rhys-mnLuff/FMS-Center/website/intro site/images/bench-calibration-poster.jpg

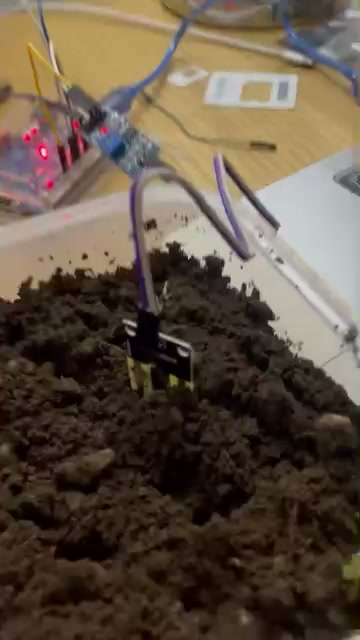
website/intro site/images/bench-calibration-poster.jpg
