rhys-mnLuff/FMS-Center/website/intro site/images/context-paddy-farmers.jpg

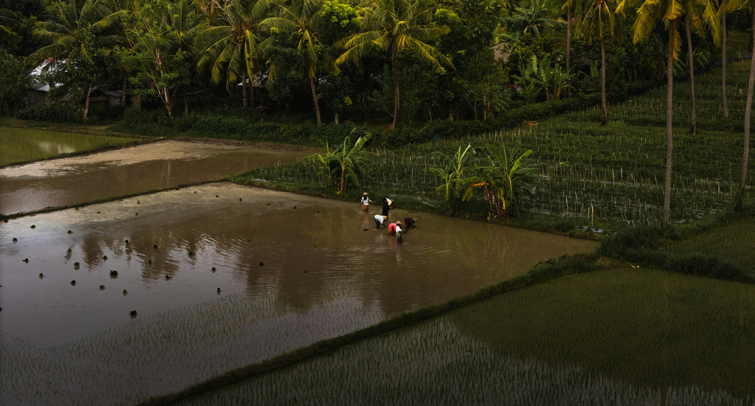
website/intro site/images/context-paddy-farmers.jpg
