rhys-mnLuff/FMS-Center/ROADMAP.md

# Roadmap

Pulled directly from the project's live goal tracker. Status and target dates are real and current as of September 2026 — this file should be updated as goals move, not left to drift out of sync.

## North Star (target: September 2027)

**FMS is a deployed, recognized flood-warning system with documented real-world impact.**

Success criteria: at least one institutional partner has FMS installed; logged alert data from real conditions; at least one national or international recognition; a public writeup a stranger can read and understand.

Why it matters: this is the version of FMS that reads as extraordinary rather than as a school project — real units in real locations, real people relying on the alerts, outside recognition confirming it. Everything else below is a step toward this.

## Quarterly goals

| Goal | Target date | Status | Success criteria |
|---|---|---|---|
| End-to-end prototype on video: water trigger → SMS with location → cloud dashboard | 2026-09-21 | In progress | One unbroken take: dunk test fires an SMS with correct coordinates and a matching dashboard entry, using the soldered HC-12 modules and the SIM module |
| Signed pilot or partnership with PDRF or an equivalent institution | 2026-11-30 | In progress | A written agreement, letter of support, or documented pilot layout naming FMS and a partner organization |
| First field deployment with logged real-condition data | 2026-12-15 | Not started | At least one unit installed outside a workbench, running 2+ weeks, with a data record and install photos |
| Submit to Congressional App Challenge and National STEM Challenge | 2026-11-01 | Not started | Both entries submitted before deadline with a finished pitch video, working demo, and writeup |
| FMS survives a posting change — a local maintainer can service a unit without Rhys | 2027-03-31 | Not started | At least one person who isn't Rhys has assembled or serviced a unit using only the written documentation, and can be named as a local maintainer |

## Monthly goals

| Goal | Target date | Status |
|---|---|---|
| Public presence live: project site, GitHub repo, technical writeup | 2026-09-30 | Not started (this repo is the first piece of it) |
| Secure a technical mentor for FMS | 2026-09-30 | Not started |
| Capture the full six-shot competition footage set | 2026-09-25 | Not started |

## Why "FMS survives a posting change" is on this list

Foreign Service postings end. If FMS only works while Rhys is in Manila holding it together, it's a project. If a Filipino partner can build, install, and service units from the documentation alone, it's infrastructure. That's also the honest version of the work — a flood system for Metro Manila should belong to the people who live with the flooding, not depend indefinitely on the person who happened to build the first one.

## What's deliberately not on this list yet

Multi-hop mesh routing, a finalized solar/battery spec, and a signed field deployment are all real next steps, but none of them have a committed target date in the tracker yet. They belong in this roadmap once they do — adding speculative dates here would undercut the point of keeping this file accurate.
