rhys-mnLuff/FMS-Center/website/intro site/images/context-flood-aerial.jpg

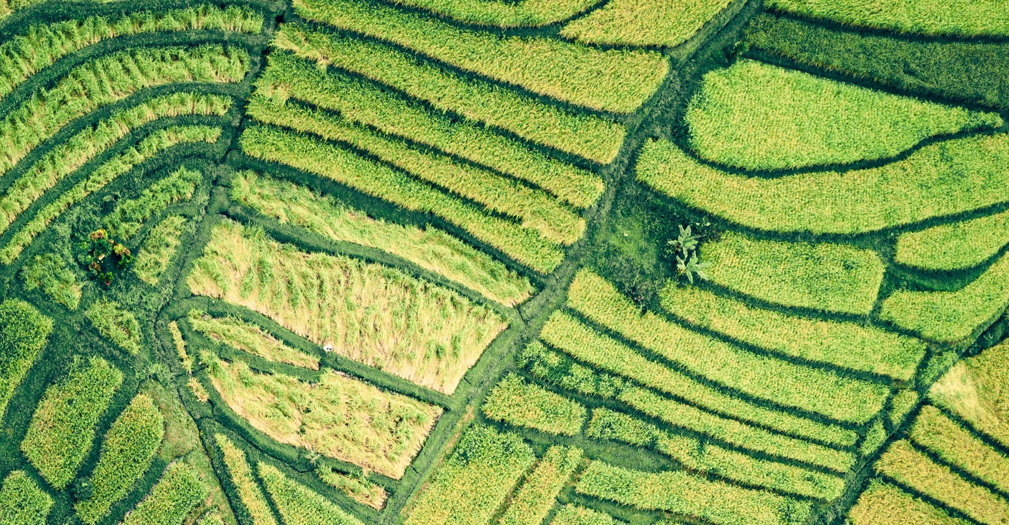
website/intro site/images/context-flood-aerial.jpg
