rhys-mnLuff/FMS-Center/website/intro site/images/context-storm-field.jpg

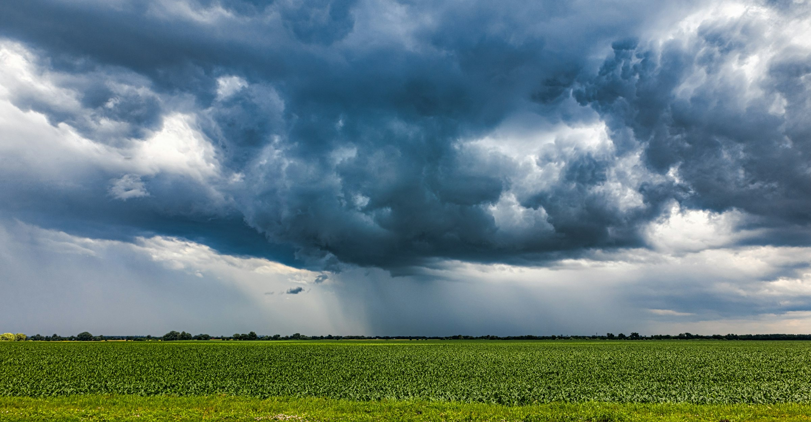
website/intro site/images/context-storm-field.jpg
