rhys-mnLuff/FMS-Center/website/intro site/images/field-deployed.jpg

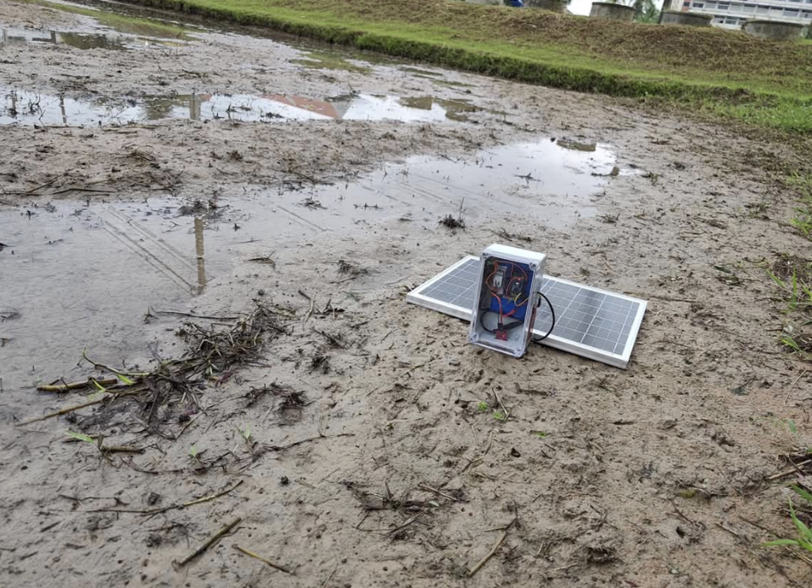
website/intro site/images/field-deployed.jpg
