rhys-mnLuff/FMS-Center/website/intro site/images/field-site.jpg

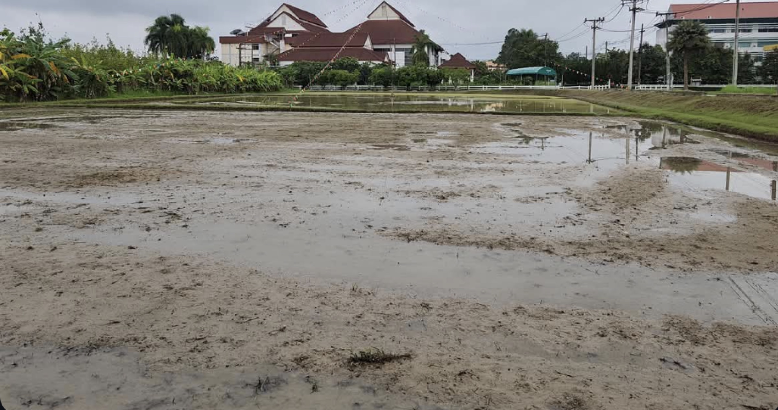
website/intro site/images/field-site.jpg
