rhys-mnLuff/FMS-Center/website/intro site/images/unit-detail.jpg

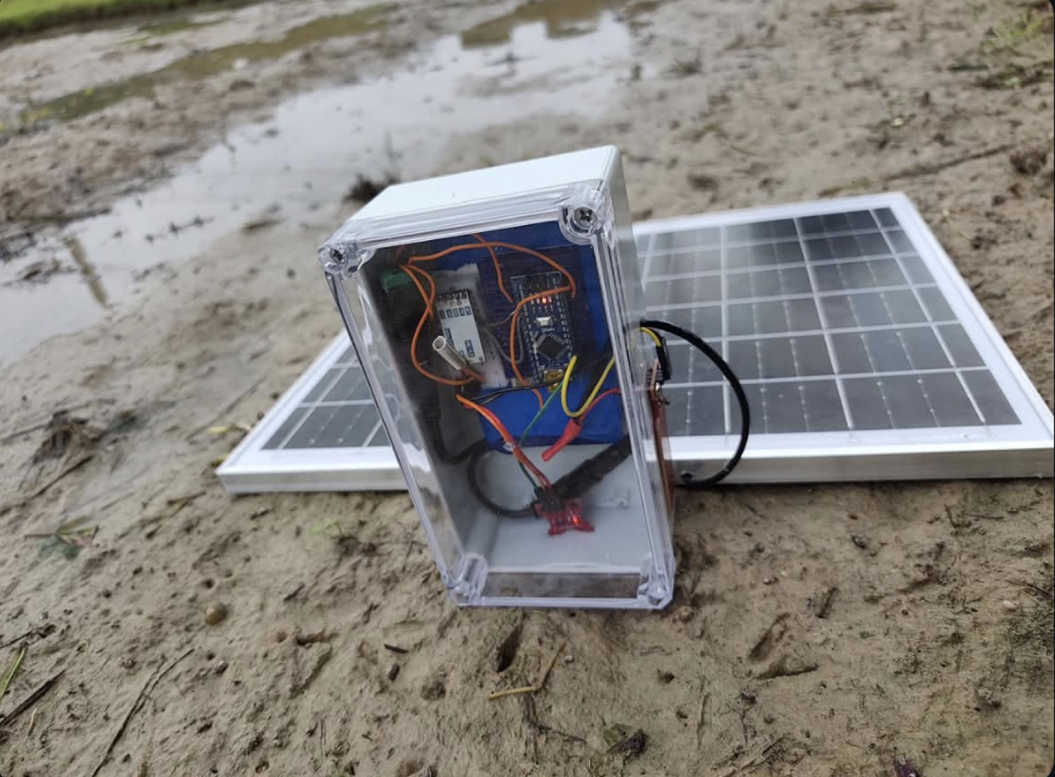
website/intro site/images/unit-detail.jpg
