rhys-mnLuff/FMS-Center/website/intro site/images/unit-panel.jpg

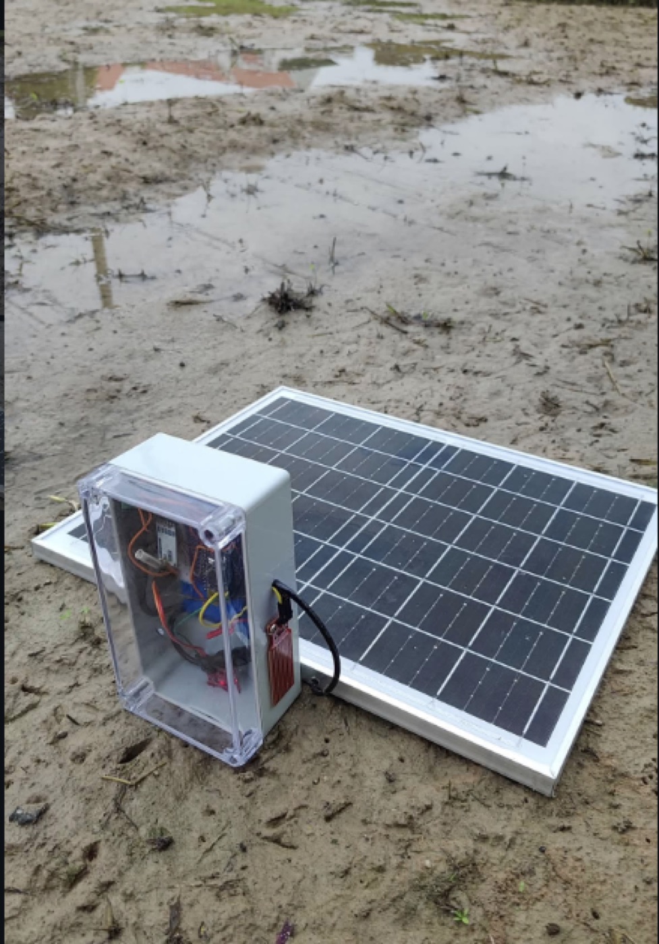
website/intro site/images/unit-panel.jpg
