rhys-mnLuff/FMS-Center/dashboard-demo/MAKING_IT_REAL.md

# From demo to deployed system

What the console currently shows, what is actually behind it, and the order of
work to close the gap. Dates reference the goals already in `ROADMAP.md`.

---

## 1. Where things actually stand

| Layer | State |
|---|---|
| Sensor hardware | Built. Soldered HC-12 radios, SIM module, probes |
| Radio link | Working, 340m verified in saturated paddy |
| `Sensor_code` | Reads probes, transmits `<NODE_ID,soil,water>` |
| `Base_code` | Receives, thresholds, sends SMS, posts to ThingSpeak |
| Soil calibration | **One round.** Dry 875.0 (SD 23.0), saturated 385.4 (SD 25.1), n=5 each |
| Water calibration | **None.** Direction confirmed, no depth mapping |
| Rain gauge | **No hardware.** Entirely modelled |
| Alert levels L0–L3 | **Console only.** Firmware fires a single threshold |
| Prediction / forecast fusion | **Console only.** Firmware does not forecast |
| Advisory text | **Console only, templated** |
| Dashboard | **Simulated.** No live node has ever fed it |

The honest summary: the hardware and the radio work. The calibration is one
round of five readings on one soil type. Everything above the threshold check
— levels, prediction, forecast fusion, advisory — exists only in the browser.

---

## 2. Critical path

One item blocks more than anything else:

> **Log a real wetting event: readings and timestamps, from rain starting
> through to standing water.**

It is the only way to get the soil drop rate, the saturation→standing-water
interval, and any means of checking a prediction against what happened. Until
it exists:

- `RAPID_DROP_CALIBRATED` stays `false` and L2 cannot fire on rate
- the saturation→water stage stays labelled `untimed`
- no accuracy figure can be quoted, in a competition entry or anywhere else

Everything in Phase 2 depends on it. It needs one node in a field and one
storm, so it is bounded by weather, not by effort — which is exactly why it
should start first.

---

## 3. Phase 1 — Calibration (blocks everything)

From the Findings Brief's own open-work list.

| # | Task | Effort | Output |
|---|---|---|---|
| 1.1 | Field capacity: soak, drain 24–48h, 5 readings | 2 days elapsed, ~1h work | Replaces the **estimated** 552–699 healthy band |
| 1.2 | Soil rounds 2 and 3, dry / FC / saturated | 2 × half day | n=15 per state; tightens the ±2SD bands |
| 1.3 | **Log one real wetting event** | 1 install + 1 storm | Drop rate; saturation→water interval |
| 1.4 | Water probe at set depths (1cm, 2cm, 4cm) | Half day, bench | Turns "water contact" into a depth |
| 1.5 | Rain probe under light and heavy spray | Half day, bench | Light-vs-heavy, currently on/off only |
| 1.6 | Idle readings, all probes, 24h | 1 day passive | Confirms the 30 and 980 buffers |

**After Phase 1** the `est` markers come off the healthy band, the fast-drop
constant can be set, and the rain gauge can report intensity instead of a
boolean.

---

## 4. Phase 2 — Firmware

Bring `Base_code` up to what the console already models.

Most of this table is now **done** — it was written against an older
`Base_code` and was still listing shipped work as outstanding. Re-checked
against `Base_Code.ino` on 2026-11-05, line numbers in brackets.

| # | Task | State | Evidence |
|---|---|---|---|
| 2.1 | Brief's thresholds | **done** | `ALERT_RULES_BRIEF 1`; soil 436 / water 30 / clear 470 [120–128] |
| 2.2 | Levels instead of one threshold | **done** | `RISK_LEVELS 1` → NORMAL/WATCH/WARNING/FLOOD, uploaded as field8 |
| 2.3 | Sustain counting, 3 readings | **done** | `alertCount >= ALERT_CONFIRM_READINGS` [548] |
| 2.4 | **Per-node SMS cooldown** | **open** | Still one global `lastSmsTime` [145, 1036] |
| 2.5 | Rolling mean before rate | **open** | Dashboard-side only |
| 2.6 | Check the HTTP response | **done** | Parses `+HTTPACTION:` and reports the code [1154–1172] |
| 2.7 | Log `AT+CSQ` | **done** | Called in the modem health check [803], with `+CREG` and `+CPIN` |
| 2.8 | Battery sensing | **done** | Real readings arriving: 3660 mV, −78 mA, 8% |
| 2.9 | Soil fault (≥960 = probe out) | **done** | `RISK_SOIL_FAULT_FROM` [387, 951] |

**2.4 is the one still worth doing first.** It is a correctness bug, not a
feature: during a real regional flood — the exact scenario this exists for —
the second and third nodes to flood are silently suppressed for an hour.

**2.10, new and not previously listed: a failed upload drops the reading.**
`sendToThingSpeak()` reports the failure and moves on; there is no retry and
no queue. One lost reading does not matter much, but a weak-signal window
leaves a hole in the series that the dashboard's rate calculation then
interpolates straight across.

---

## 5. Phase 3 — Backend

ThingSpeak accepts the data but can't drive the console.

| # | Task | State | Notes |
|---|---|---|---|
| 3.1 | Ingest endpoint, same query-string format | **done** | `server/fms_server.py`, stdlib only |
| 3.2 | Time-series storage | **done** | SQLite; a node is ~4.3k readings/day at the 20s minimum |
| 3.3 | Point the console at the API | **done** | `Live feed` button; same origin by default |
| 3.4 | Run the prediction server-side | open | Move `floodForecast()` out of the browser so alerts fire with nobody watching |
| 3.5 | Offline detection from upload gaps | **done** | `lastSeen` is the reading's own timestamp; 10 min matches the firmware |
| 3.6 | **Hosting** | **open — now the blocker** | See below |

**3.6 is what stands between this and a live site.** `SERVER_HOST` is compiled
into the firmware, and the current value is a Cloudflare *quick* tunnel
hostname — those are randomly regenerated on every launch and thrown away when
the process stops. The one in the sketch has been dead for two weeks. Every
restart currently means an edit, a recompile and a reflash.

Checked 2026-11-05: there is no longer a free tier that is both always-on and
plain-HTTP. Render's free web service sleeps after 15 minutes and takes about
a minute to wake, which is far past the modem's 10s `AT+HTTPACTION` timeout —
every reading after an idle period would fail. The realistic options are a
small paid VM (~$4–5/mo) or Oracle Cloud's Always Free VM.

**3.4 matters more than it looks.** Today the prediction only exists while a
browser tab is open. For it to be a product it has to run without one.

---

## 6. Phase 4 — Deployment

Against `ROADMAP.md`'s 2026-12-15 goal.

| # | Task | Notes |
|---|---|---|
| 4.1 | Finalise panel wattage and battery capacity | `HARDWARE.md` flags both as unspecified |
| 4.2 | Itemised BOM behind the $120 target | Currently a ceiling, not a costed bill |
| 4.3 | Enclosure survives a full wet season | Weatherproofing is pilot objective 01 |
| 4.4 | Install 1 node, 2+ weeks, logged | The roadmap's own success criterion |
| 4.5 | Local maintainer services it from the docs alone | 2027-03-31 goal; the real test of 4.2 |

---

## 7. The AI question

The current prediction is **not machine learning** — calibrated thresholds plus
a least-squares regression fitted per node at runtime. The fit is discarded
each window; nothing is trained, nothing accumulates.

Phase 1.3 is what changes that. With logged events you could honestly:

- fit the soil drop rate from data instead of leaving it unset
- learn per-site infiltration curves — different soils respond differently
- replace the fixed decay constant with one fitted to observed dry-back

That is still classical statistics rather than deep learning, and it is the
right size for the data. **Roughly 20–30 logged wetting events** across sites
would support it. One storm season at three nodes is plausibly enough.

Until then: *"a regression model fitted in real time to each node's data,
fused with live meteorological data"* is accurate. *"Trained"* is not.

---

## 8. Order of work

```
1.3 log a wetting event  ──────────────► unblocks everything
2.4 per-node cooldown    ──────────────► correctness bug, do now
1.1 field capacity       ──┐
1.2 soil rounds 2 and 3  ──┼──────────► removes the "est" markers
2.1 real thresholds      ──┘
3.1 → 3.3 backend        ──────────────► console on real data
2.2 → 2.3 levels         ──────────────► firmware matches the model
3.4 server-side predict  ──────────────► alerts without a browser
4.x deployment
```

Two things are cheap and unblock the rest: **start logging a wetting event**,
and **fix the per-node cooldown**. Neither waits on anything else.

---

## 9. Cost

| Item | Estimate |
|---|---|
| Phase 1 calibration | ~$0, bench time |
| Battery sensing parts (2.8) | <$5/node |
| Hosting (3.6) | $5–10/mo |
| SIM data | Existing |
| 3-node pilot | ~$360 at the $120 target |

Nothing here needs funding. It needs a storm, a weekend of bench work, and
about two weeks of software.
