rhys-mnLuff/FMS-Center/(commit log)

2026-09-01 Create Sensor_code
2026-09-03 Add flood monitoring dashboard demo
    Self-contained local demo (dashboard-demo/index.html) simulating live
    telemetry from the FMS sensor network — node cards, flood-risk trends,
    field map, SMS-style notifications, and a live weather-vs-sensor impact
    analysis (Open-Meteo). Alert logic, thresholds, packet format, and
    calibration data are sourced directly from Base_code/Sensor_code/
    CALIBRATION.md, with a Technician view disclosing where the demo
    simplifies or extends the real firmware's current behavior.
2026-09-11 Add technician dev console and soil health bands to farmer dashboard
    dev.html is a separate installer/technician view: fleet-wide stats, raw
    telemetry with battery and node-failure state, an on-demand manual
    analysis trigger, and a field-capacity calibration wizard. Anything not
    backed by the current firmware is labelled (the rain gauge node is marked
    planned, battery telemetry speculative).
    index.html gains banded soil-health charting so a grower can see at a
    glance when a reading leaves the healthy range, rather than reading a
    bare number.
2026-09-11 Add intro marketing site
    A public-facing site for FMS at website/intro site/, positioned around
    agricultural management rather than flood warning: the headline question
    is what the soil is doing, with saturation alerts as one capability among
    several. Framing is grounded in what the firmware actually does -- the
    0-100 index from calculateSoilHealth(), the STATUS text-back query, and
    the wilting/optimal points in Base_code.
    Claims are held to the same line as the repo docs. Dry-side irrigation
    alerts are marked planned, because today alerts fire only on the wet side
    (soil < SOIL_ALERT_THRESHOLD or water > WATER_ALERT_THRESHOLD). Range is
    given as the measured 340m, not a datasheet figure.
    P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
2026-09-20 Drop farmer dashboard; add flood prediction to the technician console
    Removes dashboard-demo/index.html. The dev console is now the only
    dashboard, so its remaining links and copy referring to a "farmer view"
    are gone too.
    Flood Prediction: pick a node from the map (or a chip, or its sensor
    card) and the console fits an ordinary least-squares trend over its last
    24 raw readings, extrapolates each series to its own threshold, and
    reports the sooner of the two with the fit's r-squared as confidence.
    Live Open-Meteo rain sits beside the projection deliberately -- it is not
    an input, so the two disagreeing is itself the signal: ground wetting
    with no rain forecast points at irrigation, drainage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
2026-09-20 Rebuild the console on the Sensor Findings Brief (2026-09-17)
    The brief supplies measured calibration and a defined alert model, so the
    console now runs on its numbers instead of the placeholders.
    Thresholds. Soil flood 436 (flooded mean +2SD), water 30, rain 980 --
    all padded past the bench figures so noise doesn't fire false alerts.
    Clearing goes through 470 as hysteresis. The old soil 450 / water 200
    pair is gone, and water polarity is no longer "unverified": the brief
    confirms water reads up when wet while soil and rain read down, so the
    three probes are normalised to 0=dry 1=wet before being compared.
    Alert model. Replaces the ad-hoc state machine with the brief's four
    levels: L0 norm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
2026-09-20 Verify the model against the brief; fix state/level mismatch and overflow
    Verification pass over the Findings Brief integration. Three real bugs.
    An L1 Watch node displayed as "Safe". The table's state came from a
    debounce machine keyed on level>=2, so the brief's L1 -- raining, or soil
    in the 437-551 band -- left the row reading Safe while the prediction
    panel beside it said Watch. LEVEL_STATE existed for this and was never
    wired. Below the alert line the displayed state now tracks the level
    directly; L2/L3 still need SUSTAIN_COUNT consecutive readings before
    committing to ALERTED, and clearing still goes through the hysteresis
    band. Verified: clearing from a flood at soil 490 lands on Wat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
2026-09-25 Tighten dev console layout
    Four things that read as unconsidered rather than designed.
    Fleet stats wrapped 8 + a ragged 6 (there are 16 tiles, not 14) because
    the grid was auto-fit. Fixed tracks instead: 8 across for two even rows,
    4 at mid width, 2 on narrow. Economics gets its own count so its 6 tiles
    fill a row rather than inheriting the 8.
    The rain gauge card was mostly empty -- a dial on the left and four
    label/value rows stretched the full width with every value stranded at
    the far edge. Body is now dial / compact reading cells / caveat across
    three columns, and the dial drops 120px to 96px.
    The gauge track was #161c24 against a #141a21 card -- two hex values
    apart and effectively i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
2026-09-25 Make the forecast an input to the prediction, not a panel beside it
    The prediction you asked for fuses node data with public weather. What was
    there only displayed them side by side: the ETA came from a straight-line
    fit to the soil trend, and the Open-Meteo figures sat next to it without
    ever touching the maths. Same trend gave the same answer whether a storm
    was coming or the sky was clearing.
    floodForecast() now simulates forward in reading-sized steps with the
    hourly forecast driving it. The measured wetting velocity is the node's
    own; what the forecast supplies is how long that velocity survives. While
    rain is falling or forecast the rate holds; once the forecast goes dry it
    decays, so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
2026-09-27 Add demo sequence, live pipeline panel and video script
    Three things for recording a demo, plus a real bug they surfaced.
    Run flood sequence drives a node through the brief's cascade on a fixed
    seven-beat timeline at 4x, so a recording hits the same marks every take.
    It moves the scenario clock rather than writing readings, so what is being
    demonstrated is the real pipeline: same thresholds, same debounce, same
    projection.
    How the prediction works renders the five stages -- inputs, normalise,
    classify, project, output -- with this node's live values in them, so the
    algorithm can be pointed at on camera instead of narrated blind. Every
    figure shown is the one the prediction actually used on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
2026-09-27 Rewrite the video script for a pre-recorded cut
    The previous script assumed live narration over the demo sequence. For an
    edited video that structure is wrong: picture and voiceover are recorded
    separately and every shot can be retaken.
    Now a shot list of eight scenes cutting between the field stills, the 11s
    bench-calibration clip and three screen captures, with the voiceover
    written per scene and each screen capture specified separately -- what to
    frame, how long is needed, and for the prediction take, which beat of the
    sequence is the one worth having (step 4 of 7, where the panel reads
    ~2 min and the node's state still says Watch).
    Timed the voiceover at 150 wpm against its slots. Two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
2026-09-27 Reweight the video script toward the model
    Hardware becomes context; the prediction is the spine. Shots 5 and 6 now
    run 86s together, 48% of a 2:59 runtime, against roughly a third before.
    The AI framing section is the substantive change. The claim that holds up
    is that this fits a least-squares regression to each node's live stream
    and fuses it with an external forecast feed -- regression is a model
    fitted to data, and saying so is accurate. What it is not is trained:
    there is no corpus, the fit is thrown away each window, nothing
    accumulates. The script separates those two explicitly, gives the single
    strongest true sentence to lead with, and keeps the prepared answer for a
    judge who push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
2026-09-27 Cut the video script to screen recording only
    Drops the photo montage, the damage statistics and the atmospheric
    setup. Five shots: the site, then the console, then pricing. 2:14 instead
    of 2:59, and the file halves from 176 lines to 93.
    Timed at 150 wpm: every block inside its slot, timeline contiguous, shot
    list matching.
2026-09-27 Add the advisory layer, labelled planned and simulated
    Closes a real gap: Base_code texts "Soil: 455 Water: 75", which a farmer
    cannot act on. The advisory turns the model's output into an instruction,
    and shows the firmware's current text beside it so the difference is
    visible rather than asserted.
    Simulated is the language generation ONLY, and the badge says so. Every
    fact in the output comes from the live pipeline -- level from
    assessLevel, ETAs from floodForecast, band from soilZone, rain from the
    forecast feed. Swapping templates for a model call would change how these
    read, not what they say. A technician column keeps the numbers the farmer
    message deliberately drops.
    Bug this expose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
2026-09-27 Add a per-field forecast page
    forecast.html is a weather view that differs from a normal one in the
    thing that matters: it reports per field, not per region. Live Open-Meteo
    regional conditions and a 12-hour hourly rainfall strip, then one card
    per node projecting how that specific block responds -- each starts from
    its own soil state and sheds water at its own rate, so the same sky gives
    three different answers. Under a 40mm profile: North Rice Paddy holds
    (healthy soil, good drainage), East Canal reaches standing water in 2.0h
    (already wetter than ideal, drains poorly), Riverside absorbs it (drying
    out, fair drainage). That divergence is the argument for measuring
    ground rather than readin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
2026-09-27 Live readings on the forecast page, and a link to it from the console
    The forecast page held three fixed soil values, so it read as a snapshot
    next to a console that visibly ticks. Readings now step on the same 10s
    interval, each field running its own behaviour -- one steady, one
    wetting toward saturation, one drying back -- inside the brief's measured
    envelope and carrying its ~5% inter-reading wobble, so the cards jitter
    the way a real probe does rather than sliding smoothly. Each card shows
    how long ago it last reported.
    Field Forecast link added to the console header; the forecast page
    already linked back.
    Fixed while testing: if the Open-Meteo fetch failed the page rendered
    nothing at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
2026-09-27 Fix the forecast page appearing dead on load
    The page rendered nothing until Open-Meteo answered. The request was not
    failing, just slow, so neither the success path nor the error path ran
    and the field cards -- which never needed weather -- sat behind a request
    they do not depend on. Measured 16 seconds with zero cards on screen.
    Three fixes. Fields now render immediately on load and the forecast fills
    in when it arrives. A hanging request aborts after 8s so it falls into
    the degraded path instead of waiting forever. And the readings were
    technically live but moved 1-3 ADC every 10 seconds, which is invisible:
    the interval is now 4s with larger steps, and the "reading Xs ago"
    counter ticks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
2026-09-27 Expand the demo script with the technical detail
    Five shots at 3:45, adding the numbers a technical judge will want: 10-bit
    ADC and raw counts, 433MHz, the 436 saturation threshold as flooded mean
    plus 2SD, the three-reading debounce and the separate 470 hysteresis
    band, least-squares over 24 readings, exponential decay on the wetting
    rate, r-squared as the confidence source. Sentences stay short.
    Timed at 150 wpm: every shot inside its slot, timeline contiguous.
2026-09-27 Full script: console walkthrough plus per-beat forecast section
    Part two breaks the forecast page into six beats, each naming the element
    to point at -- regional band, then the three field cards in turn, then the
    pull-back -- rather than leaving the page as one undifferentiated shot.
    Adds the navigation step, the storm toggle, and what to say if asked about
    the substituted profile.
    Also notes what drifts on camera: the age counter ticks every second and
    East Canal's soil moves during a long take, so values should be read off
    screen rather than the page.
    Timed at 150 wpm: every unit inside its slot, timeline contiguous. The
    3:00 alternative is verified rather than asserted -- cutting Shot 2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
2026-09-27 Switch the script to software vocabulary
    Replaces the mechanical framing throughout. Channels rather than probes,
    ingest endpoint rather than base station, integers 0-1023 rather than a
    10-bit ADC, calibration dataset rather than bench samples, state machine
    rather than alert logic, retention coefficient rather than drainage,
    external forecast API rather than regional weather. The RF link and the
    SIM are gone entirely -- they were never the point.
    The pipeline stages now read as stages: feature normalisation,
    classification, least-squares regression over a rolling window,
    fusion with an external API conditioning the decay.
    Rebalanced slots after the rewrite -- Shot 1 got shorter and Shots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
2026-09-27 Rewrite the script in plain language
    Same software framing, but said in ordinary words. The ideas are now
    described rather than named: "we draw a line through the last twenty-four
    readings and measure how steep it is" instead of least-squares regression
    over a rolling window; "it switches off at a different number than it
    switched on" instead of a hysteresis band; "how fast this field is taking
    on water" instead of a gradient.
    Checked the narration for jargon that would stall a non-technical judge
    -- ingest, inference, coefficient, normalisation, payload, hysteresis,
    classifier, API and the rest are all gone from the spoken lines. They
    survive only in the prepared answer for a judge who ask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
2026-09-27 Add a single-block version of the forecast narration
    Beats 1-6 assume cutting between cards. This is the same content as one
    unbroken take for a single continuous pan, framed as how it works in a
    real deployment and closing on what it is actually for -- not "it's going
    to rain", but which field is in trouble and how long you have.
    Runs 1:05, plain language, no jargon. Camera movement noted inline so the
    pan lands on each field as its number is spoken.
2026-09-27 Cover the software's role in the single-block forecast narration
    Adds two paragraphs: that the system fits a separate picture of each
    field from that field's own history and runs the forecast through each
    one independently -- one feed, three models, three answers -- and that it
    then produces the farmer's message rather than a row of numbers.
    Both are accurate and the file now says why, since this is what a judge
    will probe. Per-field parameters really are fitted separately, so "three
    models" is true in the sense that matters. "The system writes the
    message" describes the advisory layer, which is badged planned and
    simulated and assembles from templates -- so the note is explicit that
    you ma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
2026-10-04 Add a plan for taking the demo to a deployed system
    MAKING_IT_REAL.md sets out what is actually built against what only
    exists in the browser, then the order of work to close the gap, grounded
    in the Findings Brief's open-work list, HARDWARE.md's flagged unknowns
    and ROADMAP.md's dated goals.
    Two things come out of writing it.
    The critical path is a single item: log one real wetting event, readings
    and timestamps from rain starting through to standing water. It is the
    only route to the soil drop rate, the saturation-to-standing-water
    interval, and any way of checking a prediction against what happened.
    Until it exists the fast-drop constant stays unset, that stage stays
    labelled untimed, a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
2026-10-23 Live feed into the dashboard, and survive missing CDNs
    Adds a Live feed button that polls the ingest server and renders real
    readings instead of the simulator. Server rows are mapped into the same
    history shape stepFieldNode() produces, so prediction, advisory, charts,
    alerts and the map all work untouched. Live mode stops the simulator
    rather than blending: a chart mixing measured and invented readings would
    be worse than either alone.
    Because the bridge and the cellular path post to the same /update
    endpoint, this code cannot tell which transport produced a reading.
    Turning on THINGSPEAK_ENABLED later changes nothing here.
    Fixed a flaw this exposed. Chart.js and Leaflet load from CDNs, a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
2026-10-23 Point the base station at a tunnelled local server over HTTPS
    Turns THINGSPEAK_ENABLED on and sends uploads to a Cloudflare quick
    tunnel fronting the local ingest server, so a cellular upload reaches a
    dashboard running on localhost.
    Switches the upload to HTTPS. The earlier reasoning that this was
    impossible was wrong: TLS is terminated by the SIM7600, not the
    ATmega328P, so it costs the sketch nothing and quick tunnels only serve
    HTTPS anyway. Added AT+HTTPSSL=1 and the SSLCFG line before HTTPACTION.
    Verified before flashing: a reading posted to the public tunnel URL
    landed in the local SQLite db, so the tunnel path is sound independent of
    the hardware. Sketch compiles at 69% flash and 6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
2026-10-23 Revert to plain HTTP; the upload failure is power, not configuration
    Isolation test. I had added AT+HTTPSSL=1 and an SSLCFG line to reach an
    HTTPS tunnel, and suspected that wedged the modem, since AT+HTTPSSL is
    SIM800 syntax and the SIM7600 configures TLS differently. Reverted both
    and pointed SERVER_HOST back at api.thingspeak.com -- the plain-HTTP
    configuration this firmware was written against.
    Identical failure. The modem reports "OK | SIM card ready | signal 14/31
    ok | network registered", a packet arrives from node 1, and the upload
    returns FAILED (no reply) with the modem unresponsive afterwards. So the
    HTTPS change was not the cause and the fault is upstream of anything in
    this ske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
2026-10-23 Fix the serial bridge parser and get live board data onto the dashboard
    The reading line is pipe-separated but its fields are not in fixed
    positions: "| just booted" appears only after a reset, and an alerting
    node appends " << FLOOD LEVEL" after the risk word. The original
    field-order regex matched neither, so those lines were silently skipped
    -- including every flood reading, the one case the system exists to
    report. Parsing now splits on "|" and reads whatever fields are present,
    discarding anything after "<<" as a banner rather than a field.
    Verified against all five real line shapes: normal, FLOOD with banner,
    just-booted, WATCHING n/3, and alert-cleared. The two that used to be
    dropp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
2026-10-23 Stop live mode showing leftover simulated values
    Checking the console in live mode showed nodes 2 and 3 displaying soil
    467 and 638 with zero readings behind them, the rain gauge still drawing
    a simulated trace, and fleet averages blending real node 1 with both.
    Clearing history was not enough: the table reads n.soil/n.water directly,
    so the last simulated values kept rendering as though a node had sent
    them.
    Entering live mode now zeroes lastSeen so a node with no packet reads
    OFFLINE, blanks the rain gauge, and every numeric cell shows an em dash
    rather than a stale figure. Fleet averages cover only nodes that actually
    reported.
    The bridge also never forwarded battery, so the dashboard k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
2026-11-05 Strip the console back to a monitoring tool
    The console had drifted into looking generated: a five-box numbered
    explainer joined by arrows, a progress-track cascade with per-step basis
    tags, nine badge styles, six brightly coloured toolbar pills, a circular
    gauge, filled severity panels, coloured score cards with bars, and a line
    of explanatory text under every section heading. Individually defensible,
    together they read as a demo rather than an instrument.
    Removed outright: the "How the prediction works" panel and its renderer,
    the cascade arrows and basis chips, the brand mark, the rain dial, the
    per-node health bars.
    Quietened rather than removed: the cascade is now rule-separated cells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
2026-11-05 Remove the remaining small-text clutter
    Cut text that labelled things already obvious from context or repeated
    data shown elsewhere: the header tagline, the "Sim speed" label, the
    sub-captions under Advisory and Rain gauge, the "to 436" / "water >30" /
    "dry" sub-lines beneath metric tiles whose key already names them, the
    second forecast horizon, the firmware-comparison line under the advisory
    message, and the per-sensor footer repeating wetness, risk, rate and
    battery straight from the telemetry table above it.
    Kept what a reader needs to interpret a figure: tile keys, table headers,
    chart titles, the map legend, the "est." marker, and the "demo" marker on
    a substituted forecast feed.
    Two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
2026-11-05 Rebuild the console on a sidebar-and-cards layout
    The console was a single scrolling column of hairline-ruled sections with
    sixteen stat tiles, a sixteen-column node table and seven charts. Reworked
    it to the layout pattern the reference dashboard uses: a fixed left nav
    beside a column of soft white cards on a neutral page, a page title with
    status pills, and a six-tile KPI row at the top.
    Cuts:
    - fleet tiles 16 -> 6; the cellular link moved into a header pill so the
    "weak signal" control still has a readout
    - node table 16 columns -> 10 (dropped type, wetness %, rate, debounce,
    packets, SMS count -- all of them already shown elsewhere)
    - charts 7 -> 5; the rain and battery se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
2026-11-05 Fix the live path's timestamps, and serve the dashboard from the API
    Four things made live mode untrustworthy, all found by pointing the console
    at the 26 real readings already in fms.db:
    - ingestRows() stamped node.lastSeen with Date.now() instead of the
    reading's own timestamp, so a reading from 23 October displayed as
    "0s ago" and the node never went offline. The console was showing
    two-week-old data as current.
    - the offline threshold was 30s, which is right for the 10s simulator but
    flaps constantly on cellular, where TS_MIN_INTERVAL_MS alone spaces
    uploads 20s apart. Live mode now uses 10 minutes, matching
    NODE_OFFLINE_MS in Base_Code.ino.
    - rate of chang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
2026-11-05 Be precise about why USB power fails: transient response, not just amperage
2026-11-05 Add a cellular test that needs no sensor node and writes nothing
    Uploads are packet-driven: sendToThingSpeak() only runs when a node's
    reading arrives over the HC-12. So with the base station alone, "the modem
    cannot transmit" and "no node is sending" produce the same symptom, and
    every cellular test so far has been testing the radio chain at the same
    time.
    New 't' serial command fetches SERVER_HOST/health over cellular. No sensor
    node, and /health stores nothing, so it can be run repeatedly without
    putting readings in the series that no probe ever took. +832 bytes flash
    (71%), no change to RAM.
    check_cellular.sh drives it: flashes against a plain-HTTP host that is
    always up, sends 't', th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
2026-11-05 Get live board data onto the dashboard over USB, and stop it lying
    The board is running "FMS BASE STATION (Nov 2026)", which is newer than
    Base_Code.ino and has no source on this machine. Read the flash off the
    chip with avrdude and kept it as firmware/board-backup-2026-11-05.hex,
    verified by its own strings. It has no HTTP client at all -- no HTTPINIT,
    HTTPPARA, HTTPACTION or CGDCONT, only a leftover HTTPTERM -- and the sketch
    fills 30720 of 30720 bytes. So cellular upload was not blocked by power;
    the code is not on the chip, and there is no room to add it back. Left the
    board alone.
    serial_bridge.py could not read that firmware either: it anchored on
    "^NODE", and the Nov 2026 build prefi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
2026-11-07 Do not show a trend badge on a tile that has no value
    With the board unplugged every live tile reads em dash, but Battery still
    carried a '+20%' badge computed from stored history. A trend beside 'no
    data' claims a reading that is not there.
2026-11-07 Port the base station's SMS wording to the server, with tests that pin it
    The base texts 2-4 admin numbers itself; the 700-person list has to come
    from the server. If the two drift, an admin comparing their handset against
    a farmer's sees different words and neither trusts the system. So the
    templates are copied verbatim from Base_Code.ino's PSTR() literals and the
    tests assert byte-identical output, including the soilWords() band edges
    (436/552/700/829/960) and that water==30 is still a WARNING, not an ALERT.
    One test asserts no message ever contains a link. SMS_MAP_LINK is 0 in the
    firmware because Philippine networks were observed rejecting link texts
    (Smart, 16 Oct 2026), so location go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
2026-11-07 Zone-based alert recipients, new feed endpoint, and get phone numbers out
    Zones: each node has its own subscriber group, so a flood at node 2 texts
    zone 2 and nobody else. Texting all 700 for a one-node event trains people
    to ignore the alerts, which is the failure that matters most here.
    Subscriber numbers live in D1, never in the repo. New tables: subscribers
    (zone, msisdn, status, consent_ts -- the Data Privacy Act wants consent
    documented, so a row without it should not be texted), broadcasts (body
    stored once, not 700 times) and sms_sends (per-recipient state; PhilSMS has
    no delivery webhook so it is polled, but the column is the same either way,
    which keeps a provider switch out of th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
2026-11-07 Fix the root CA for the new endpoint, add health polling, land the zone work
    The zone/subscriber/feed work described in 856d1d0 was never actually in it:
    the `git add` sharing a command line with that commit was denied, so only the
    hex-file deletions landed. The code was on disk the whole time. It is here.
    Root CA, and this is the part that would have cost days: the base's endpoint
    moved from *.chatgpt.site to *.workers.dev, and the two use different
    certificate authorities. The old host chains to Google Trust Services GTS
    Root R4, which is what was compiled into TLS_ROOT_CA. workers.dev chains to
    Let's Encrypt -> ISRG Root YE -> ISRG Root X2 -> X1. Verified with openssl:
    the Worker validat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
2026-11-13 Dark navy theme, matching the reference
    Midnight navy page with cards lifted above it, indigo accent, rounder
    corners. Dark is now the default rather than following the OS; a saved
    choice still wins and the Appearance toggle still switches both ways.
    page #070d1b cards #111a2e inset panels #16213a
    accent #6d8bff ink #eef2fa muted #8191ae
    First attempt had the page at #0a1020 against cards at #0f1729, which is
    1.1:1 -- too close to read as layering at all. Deepened the page and lifted
    the cards instead, and added a faint inner top edge plus a drop shadow,
    since a hairline border on its own looks flat on dark.
    Chart series are indigo / rose / teal, which is where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
2026-11-13 Strip the reference sections and small text, add glass and gradients
    Removed entirely: the Cost section and the Data provenance panel. Both are
    reference material rather than operating state, and I checked both survive
    in the docs before deleting -- the calibration figures are in CALIBRATION.md
    and CALIBRATION_DATA.md, the cost table in MAKING_IT_REAL.md section 9. The
    inline markers that do the actual honesty work stay: the est. tags, the
    "planned" badge on the rain gauge, and the Simulated / Live pill.
    Also gone: every descriptive caption under a card heading, the footer
    provenance line (the header pill already says which source you are looking
    at), the calibration wizard's instructions,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
2026-11-13 Make the elements emit light, as in the reference
    Glow on the things that carry meaning rather than on everything:
    chart strokes canvas shadow set per dataset, cleared after. Threshold
    lines are excluded -- a dashed guide that glows reads as
    data. Registered only when the real Chart.js loaded,
    since the offline stub has no register().
    status dots in their own state colour. box-shadow with no colour
    falls back to currentColor, so the markup now sets both
    background and color on each dot.
    badges soft outer glow, except planned / quiet / offline, which
    are deliberate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
2026-11-14 Light theme rebuilt on the Crextio reference, and light is the default
    The background is the point of it: cool grey at the top left warming
    through to butter at the right, as two radial washes over a diagonal
    linear. Fixed attachment so it does not slide while scrolling. Cards are
    warm off-white on top of it, corners 22px.
    page #e7e8e9 -> #fbeaa6 card #fdfbf4 border #eae5d4 ink #1a1a17
    Chart series had to become theme tokens, not constants. The lime that
    carries on near-black is invisible on cream, so each theme now declares
    --series-1..3 and the rain series, nodeColors reads them live through a
    Proxy, and applyChartTheme repaints the existing lines and re-renders the
    legend and no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
2026-11-14 One sensor per area, and keep the cream theme as the default
    Reverted the white experiment -- the cream light theme is the one you
    wanted, unchanged, and it is the default. Dark is unchanged too and stays
    one click away on Appearance. The storage key bump from the last commit is
    kept, which is what makes the light default actually reach a browser that
    had been toggled to dark.
    One sensor. A deployment covers one area and an area gets one sensor, so
    three markers clustered half a kilometre apart was never the real shape.
    The node list is one entry; nothing assumes its length any more. The read
    scheduler was keyed on a literal ["1","2","3"], the flood trigger and three
    demo steps reached for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
2026-11-14 Switch SMS sending from PhilSMS to Semaphore
    PhilSMS only approves sender IDs for registered businesses. Semaphore takes
    the API key in the form body, accepts up to 1000 numbers per call, and falls
    back to the account's default sender name when none is given. Flood alerts use
    its /priority route (not rate limited); battery notices use /messages.
